AlbertoBoem/sculpTon/README.md

# sculpTon
Various materials related to SculpTon: a Deformable Interface for Musical Expression

Alberto Boem (2013-2015, Interface Cultures)
