AlbertoBoem/sculpTon/Arduino shield/sculpton_arduinoMegaShield_pcb.png

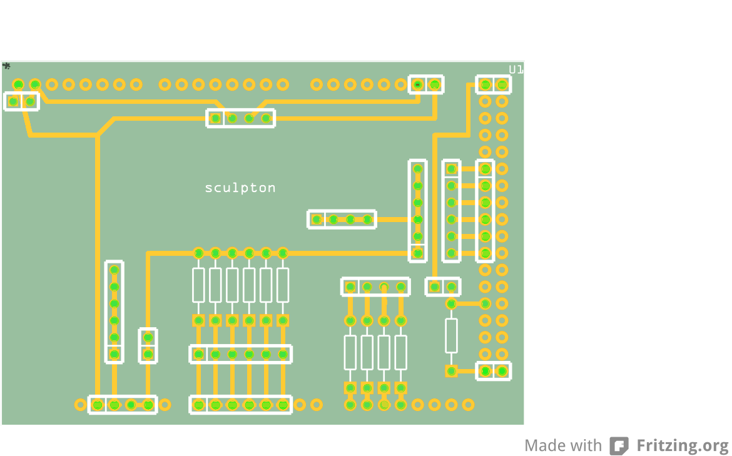
Arduino shield/sculpton_arduinoMegaShield_pcb.png
