AlbertoBoem/sculpTon/Shield/Version_B/sculpton_arduinoMegaShield_ver_B_pcb.jpg

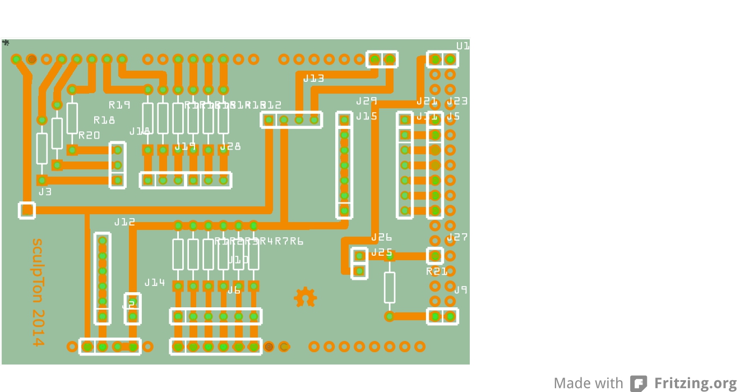
Shield/Version_B/sculpton_arduinoMegaShield_ver_B_pcb.jpg
