AlbertoBoem/sculpTon/Arduino shield/etchable_pdf/sculpton_arduinoMegaShield_etch_copper_bottom.pdf

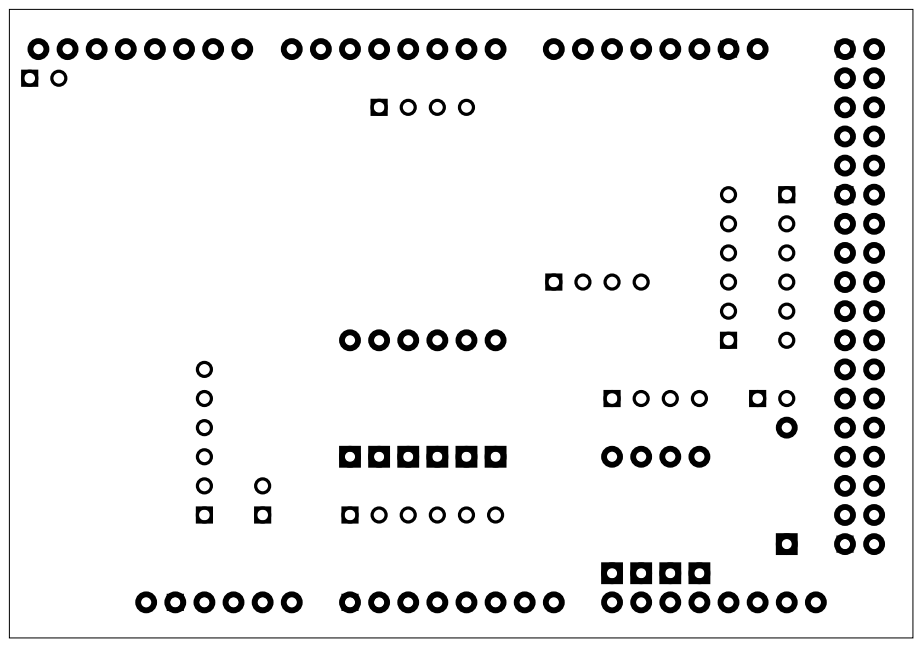
[picture p13: page 1]
