AlbertoBoem/sculpTon/Arduino shield/etchable_pdf/sculpton_arduinoMegaShield_etch_copper_bottom_mirror.pdf

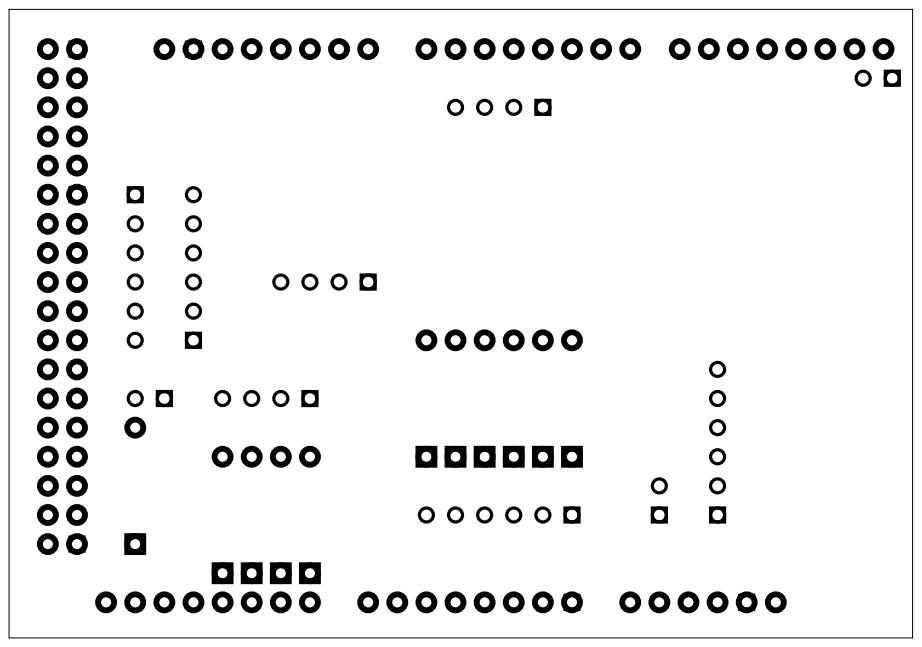
[picture p14: page 1]
