AlbertoBoem/sculpTon/Arduino shield/etchable_pdf/sculpton_arduinoMegaShield_etch_copper_top.pdf

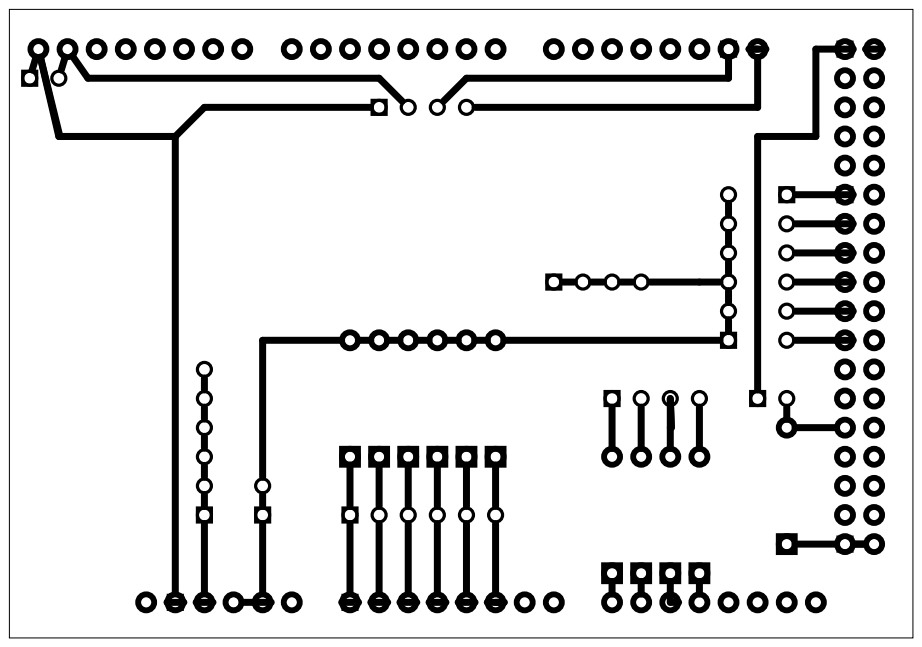
[picture p15: page 1]
