AlbertoBoem/sculpTon/Arduino shield/etchable_pdf/sculpton_arduinoMegaShield_etch_copper_top_mirror.pdf

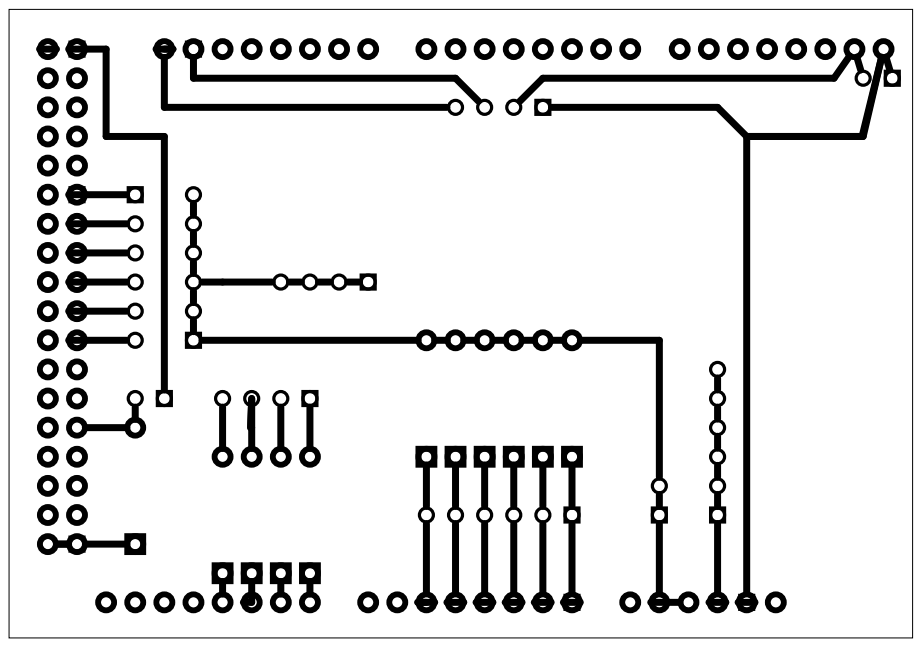
[picture p16: page 1]
