AlbertoBoem/sculpTon/Arduino shield/etchable_pdf/sculpton_arduinoMegaShield_etch_mask_bottom.pdf

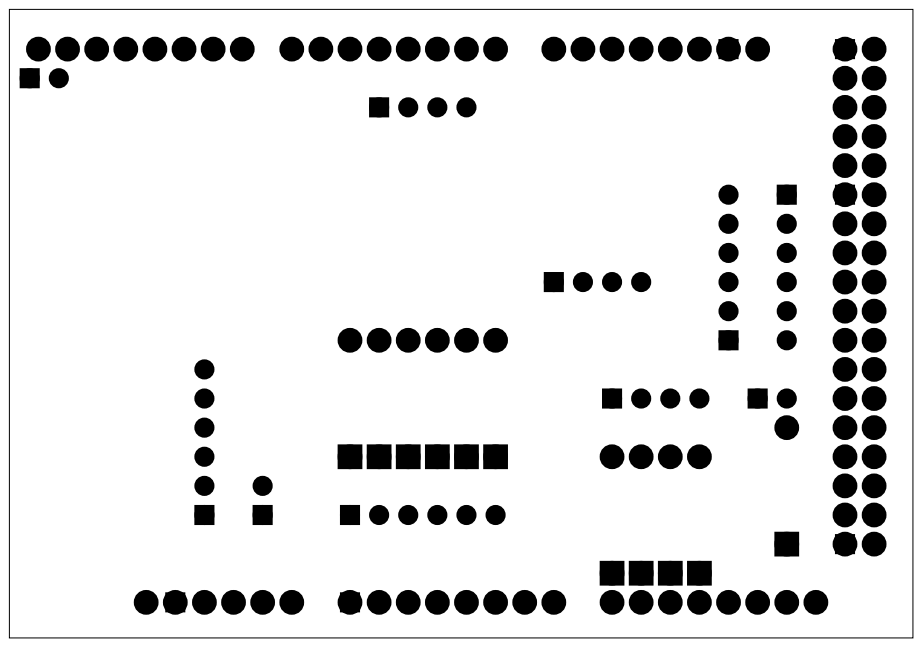
[picture p17: page 1]
