AlbertoBoem/sculpTon/Arduino shield/etchable_pdf/sculpton_arduinoMegaShield_etch_mask_bottom_mirror.pdf

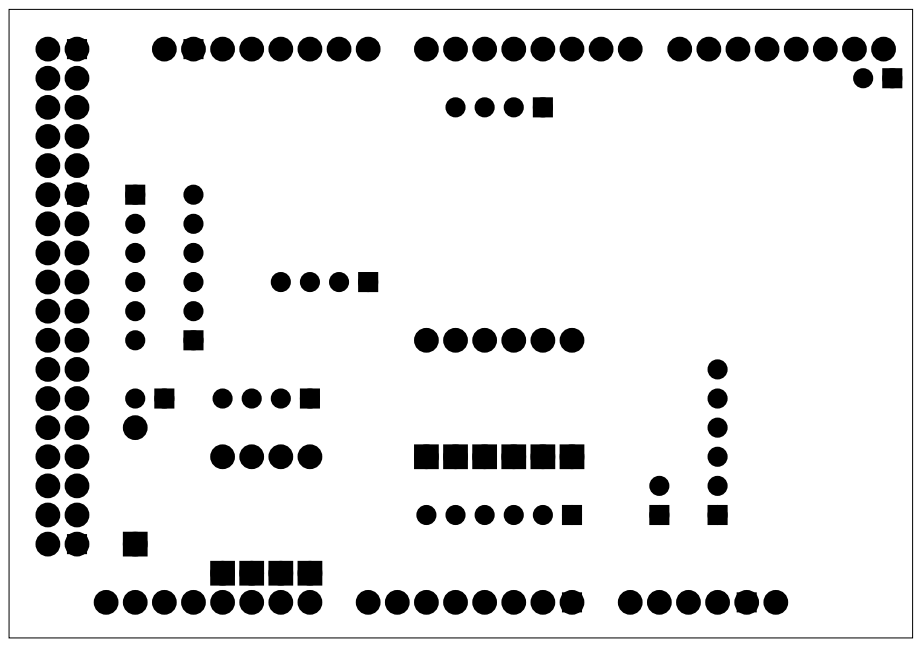
[picture p18: page 1]
