AlbertoBoem/sculpTon/Arduino shield/etchable_pdf/sculpton_arduinoMegaShield_etch_silk_top.pdf

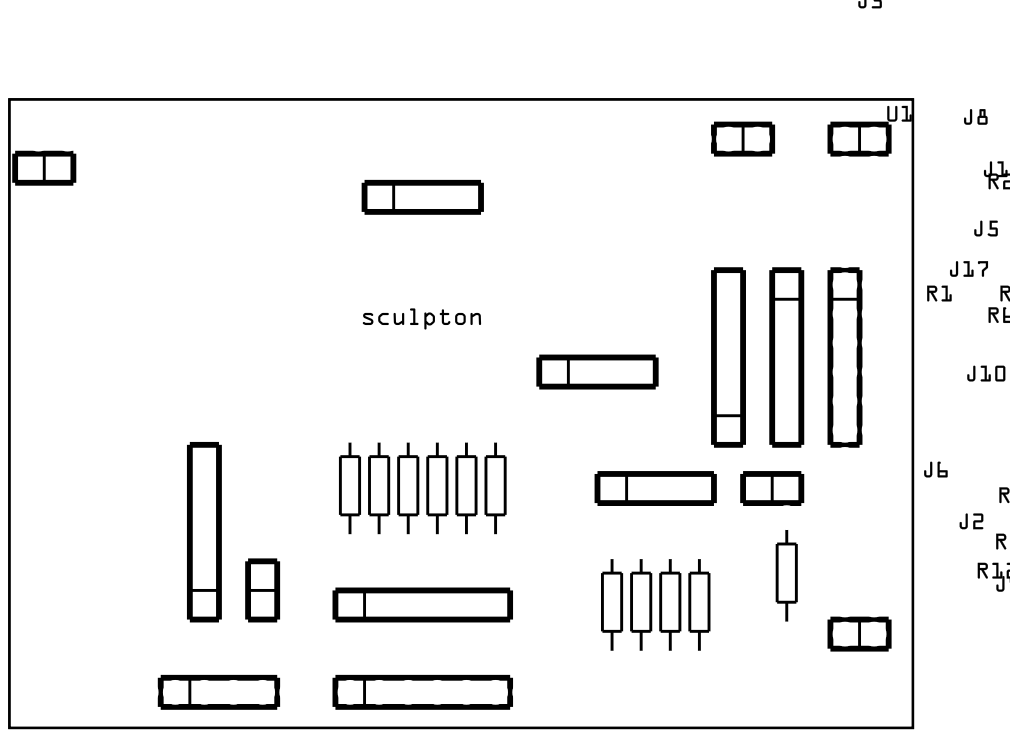
[picture p19: page 1]
