AlbertoBoem/sculpTon/Arduino shield/etchable_pdf/sculpton_arduinoMegaShield_etch_silk_top_mirror.pdf

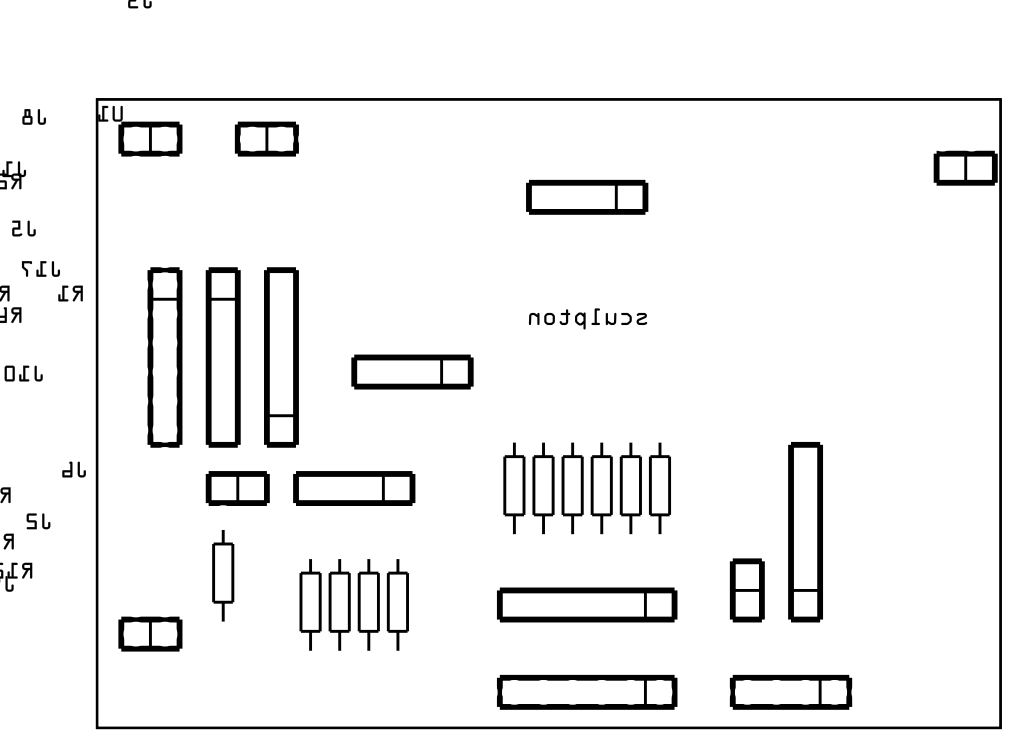
[picture p20: page 1]
