AlbertoBoem/sculpTon/(list of files, drawings)

Other design files:
Shield/Version_A/sculpton_shield_ver_A.fzz
Shield/Version_B/sculpton_arduinoMegaShield_ver_B.fzz
